Devsign-Project-rmtec/oLoRa/End Device/PCB/part/v19.1/BOM_oLoRa-part-Coprocessor_20190820155455.csv

ID | Name | Designator | Footprint | Quantity | Manufacturer Part | Manufacturer | Supplier | Supplier Part
1 | KMR221GLFS | SW3 | KEY-SMD-4.6X2.8X1.9 | 1 | KMR221GLFS | C&K | LCSC | C72443
2 | AVRISP-6 | ICSP2 | AVRISP | 1 | ?
3 | 100nF | C2 | 0603' | 1 | 0603B104K500NT | FH | LCSC | C30926
4 | ATMEGA328P-MU | U1 | QFN-32_5X5X05P | 1 | ATMEGA328P-MU | MICROCHIP | LCSC | C38896
5 | 8MHz | Y2 | X3-SMD-3.6X1.3X0.8MM | 1 | CSTCE8M00G55-R0
6 | 210S-1*10P | H1 | 210S-1X10P | 1 | 210S-1*10P L=11.6MMGold-plated black | Ckmtw | LCSC | C124372
