Devsign-Project-rmtec/oLoRa/End Device/PCB/part/v19.1/BOM_oLoRa-part-GPS_20190820155449.csv

ID | Name | Designator | Footprint | Quantity | Manufacturer Part | Manufacturer | Supplier | Supplier Part
1 | 100nF | C2,C1 | 0603' | 2 | 0603B104K500NT | FH | LCSC | C30926
2 | L80-R | U1 | L80-R | 1 | L80-R | Quectel | LCSC | C188357
3 | 210S-1*5P | H1 | 210S-1X5P | 1 | 210S-1*5P L=11.6MMGold-plated black | Ckmtw | LCSC | C124379
