Devsign-Project-rmtec/oLoRa/End Device/PCB/part/v19.1/BOM_oLoRa-part-LoRa_20190820155516.csv

ID | Name | Designator | Footprint | Quantity | Manufacturer Part | Manufacturer | Supplier | Supplier Part | LCSC Assembly
1 | NC | C19,C18 | 0805' | 2
2 | 0 | R22,R14 | 0603' | 2 | 0603WAF0000T5E | UniOhm | LCSC | C21189 | Yes
3 | U.FL-R-SMT-1(80) | JP1 | U.FL-R-SMT-1(80) | 1 | U.FL-R-SMT-1(80) | HRS | LCSC | C88374
4 | RAK811 | U7 | RAK811 LORA MODULE | 1 | RAK811 |  | RAK WIRELESS | RAK811
5 | Header-Male-2.54_1x4 | H1 | 210S-1X4P | 1 | 210S-1*4P L=11.6MMGold-plated black | Ckmtw | LCSC | C124378
