Devsign-Project-rmtec/oLoRa/End Device/PCB/part/v19.1/BOM_oLoRa-part-MainMCU_20190820155500.csv

ID | Name | Designator | Footprint | Quantity | Manufacturer Part | Manufacturer | Supplier | Supplier Part | LCSC Assembly
1 | AVRISP-6 | ICSP1 | AVRISP | 1 | ?
2 | 22 | R20,R19 | 0603' | 2
3 | 330 | R18,R17 | 0603' | 2
4 | KMR221GLFS | SW1 | KEY-SMD-4.6X2.8X1.9 | 1 | KMR221GLFS | C&K | LCSC | C72443
5 | PTC-2.0A | F2 | 1812 | 1 | MF-MSMF200-2 | BOURNS | LCSC | C210837
6 | micro 5P | USB1 | MICRO-USB-17 | 1 | - | LCSC | LCSC | C77238
7 | 8MHz | Y1 | X3-SMD-3.6X1.3X0.8MM | 1 | CSTCE8M00G55-R0
8 | 100nF | C17 | 0603' | 1 | CC0603KRX7R9BB104 | YAGEO | LCSC | C14663 | Yes
9 | ATMEGA32U4-MU | U6 | VQFN-44_L7.00-W7.00-PITCH0.50-EP5.2 | 1 | ATMEGA32U4-MU | MICROCHIP | LCSC | C112161
10 | ORH-R36A(0.6T) | LED1,LED2 | LED-0603 | 2 | ORH-R36A(0.6T) | Orient | LCSC | C205445
11 | 97.6K | R2 | 0603' | 1 | CR0603-FX-9762ELF | BOURNS | LCSC | C203901
12 | 309K | R3 | 0603' | 1 | 0603WAF3093T5E | UniOhm | LCSC | C23001 | Yes
13 | Z-211-0811-0021-001 | U1 | SIP-2.54MM-8P-CJT-H8.54 | 1 | Z-211-0811-0021-001 | Nextronics Engineering | LCSC | C190820
