Devsign-Project-rmtec/oLoRa/End Device/PCB/part/v19.1/BOM_oLoRa-part-motherboard_20190820155442.csv

ID | Name | Designator | Footprint | Quantity | Manufacturer Part | Manufacturer | Supplier | Supplier Part
1 | Z-211-0811-0021-001 | U2 | SIP-2.54MM-8P-CJT-H8.54 | 1 | Z-211-0811-0021-001 | Nextronics Engineering | LCSC | C190820
2 | 210S-1*10P | H6 | 210S-1X10P | 1 | 210S-1*10P L=11.6MMGold-plated black | Ckmtw | LCSC | C124372
3 | 5001 | U3 | CE-D-Z1.39-2.54 | 1 | 5001 | Keystone | LCSC | C238122
4 | A2541HWV-4P | H1,H2,H4 | A2541HWV-4P | 3 | A2541HWV-4P | Changjiang Connectors | LCSC | C225501
5 | Header-Female-2.54_1x5 | H3 | HDR-5X1/2.54 | 1 | 2.54mm 1*5p Female header | BOOMELE | LCSC | C50950
6 | Header-Female-2.54_1x6 | P1 | HDR-6X1/2.54 | 1 | Female header 1*6p | BOOMELE | LCSC | C40877
7 | Header-Female-2.54_1x8 | P2 | HDR-8X1/2.54 | 1 | Female headerHDR1X8-2.54 | BOOMELE | LCSC | C27438
8 | Header-Female-2.54_1x10 | H5 | HDR-TH_10PIN-V-FEMALE-PITCH2.54 | 1 | 2.54mm 1*10P Straight Female header Gold-plated | BOOMELE | LCSC | C35445
