Devsign-Project-rmtec/oLoRa/End Device/PCB/part/v19.1/BOM_oLoRa-part-power_20190820155506.csv

ID | Name | Designator | Footprint | Quantity | Manufacturer Part | Manufacturer | Supplier | Supplier Part | LCSC Assembly
1 | 1.2k | R16 | 0603' | 1
2 | 1k | R15,R2 | 0603' | 2
3 | K3-1296S-E1 | SW2 | K3-1296S-E1 | 1 | K3-1296S-E1 | HRO | LCSC | C128955
4 | SGM2036-3.3YN5G/TR | U5 | SOT-23-5 | 1 | SGM2036-3.3YN5G/TR | SGMICRO | LCSC | C92402 | Yes
5 | TP4056 | U4 | SOP-8_EP_150MIL | 1 | TP4056 | TOPPOWER | LCSC | C16581 | Yes
6 | 10uF | C16,C15 | CAP-CASE-A_3216 | 2 | TAJA106K016RNJ | AVX | LCSC | C7171 | Yes
7 | RED | LED4 | LED-0603 | 1 | KT-0603R | KENTO | LCSC | C2286 | Yes
8 | GRN | LED3 | LED-0603 | 1 | 19-217/GHC-YR1S2/3T | EVERLIGHT | LCSC | C72043 | Yes
9 | 10nF | C14 | 0603' | 1 | CGA3E2C0G1H103JT0Y0N | TDK | LCSC | C76710 | Yes
10 | 1uF | C8,C7 | 0603' | 2 | CL10B105KQ8NNNC | SAMSUNG | LCSC | C105524
11 | Header-Male-2.54_1x4 | H1 | 210S-1X4P | 1 | 210S-1*4P L=11.6MMGold-plated black | Ckmtw | LCSC | C124378
12 | MTP220 | H2 | PH-TH_2PIN-H-MALE-PITCH2.00-L | 1 | MTP220-1102R1 | MINTRON | LCSC | C376096
