Devsign-Project-rmtec/oLoRa/End Device/PCB/part/v19.1/BOM_oLoRa-part-thi_20190820155435.csv

ID | Name | Designator | Footprint | Quantity | Manufacturer Part | Manufacturer | Supplier | Supplier Part | LCSC Assembly
1 | SHT20 | U1 | DFN-6-EP | 1 | SHT20 | Sensirion | LCSC | C53865 | Yes
2 | MPU-6050_C24112 | U2 | QFN-24_4X4X05P | 1 | MPU-6050 | InvenSense | LCSC | C24112 | Yes
3 | Header-Male-2.54_1x4 | H1 | 210S-1X4P | 1 | 210S-1*4P L=11.6MMGold-plated black | Ckmtw | LCSC | C124378
4 | 100nF | C4,C1 | 0603' | 2 | 0603B104K500NT | FH | LCSC | C30926
5 | 10nF | C2 | 0603' | 1 | CC0603KRX7R9BB103 | YAGEO | LCSC | C100042
6 | 2.2nF | C3 | 0603' | 1 | CC0603KRX7R9BB222 | YAGEO | LCSC | C107082
