Devsign-Project-rmtec/oLoRa/End Device/PCB/part/v19.1/BOM_oLoRa-part-Geiger_20190820155511.csv

ID | Name | Designator | Footprint | Quantity | Manufacturer Part | Manufacturer | Supplier | Supplier Part | LCSC Assembly
1 | 10 | R21 | 0805' | 1 | RC0805FR-0710RL | YAGEO | LCSC | C96347
2 | 1K | R12,R3,R11,R10 | 0603' | 4 | RC0603FR-071KL | YAGEO | LCSC | C22548
3 | 100uF | C13 | CASE-B_3528 | 1 | TAJB107M010RNJ | AVX | LCSC | C7196 | Yes
4 | 10K | R13 | 0603' | 1 | 0603WAF1002T5E | UniOhm | LCSC | C25804 | Yes
5 | 100K | R9,R1 | 0603' | 2 | RC0603FR-07100KL | YAGEO | LCSC | C14675
6 | 10M | R8,R7,R6,R5,R4 | 0603' | 5 | RTT031005FTP | RALEC | LCSC | C103202
7 | 100pF | C12,C11 | 0603' | 2 | 0603CG101J500NT | FH | LCSC | C1635 | Yes
8 | 10nF 1kV | C10,C9,C6,C5 | 1206 | 4 | 1206B103K102CT | Huaxin S&T | LCSC | C303948
9 | 100nF | C4 | 0603' | 1 | 0603B104K500NT | FH | LCSC | C30926
10 | 10mH | L1 | IND-505040 | 1 | FNR5040S103MT | cjiang | LCSC | C167995
11 | MMBT3904 | Q1 | SOT-23(SOT-23-3) | 1 | MMBT3904 | SK | LCSC | C111113 | Yes
12 | MMBTA44G | Q3 | SOT-23(SOT-23-3) | 1 | MMBTA44G-AE3-R | UTC | LCSC | C84882 | Yes
13 | ES1J | D3,D2,D1 | SMA(DO-214AC) | 3 | ES1J | ON Semicon | LCSC | C232830
14 | WJ142V-5.08-02P-14-00A | CN1 | WJ142V-5.08-2P | 1 | WJ142V-5.08-02P-14-00A | Ningbo Kangnex Elec | LCSC | C153288
15 | Header-Male-2.54_1x6 | P1 | HDR-6X1/2.54 | 1 | Header-Male-2.54_1x6 | BOOMELE | LCSC | C37208
