Devsign-Project-rmtec/oLoRa/End Device/PCB/part/v19.1/Schematic_oLoRa-part-LoRa_part-LoRa_20190820155410.pdf

## https://pdf.direnc.net/upload/rak811-breakout-board-specification.pdf

## LoRa Module

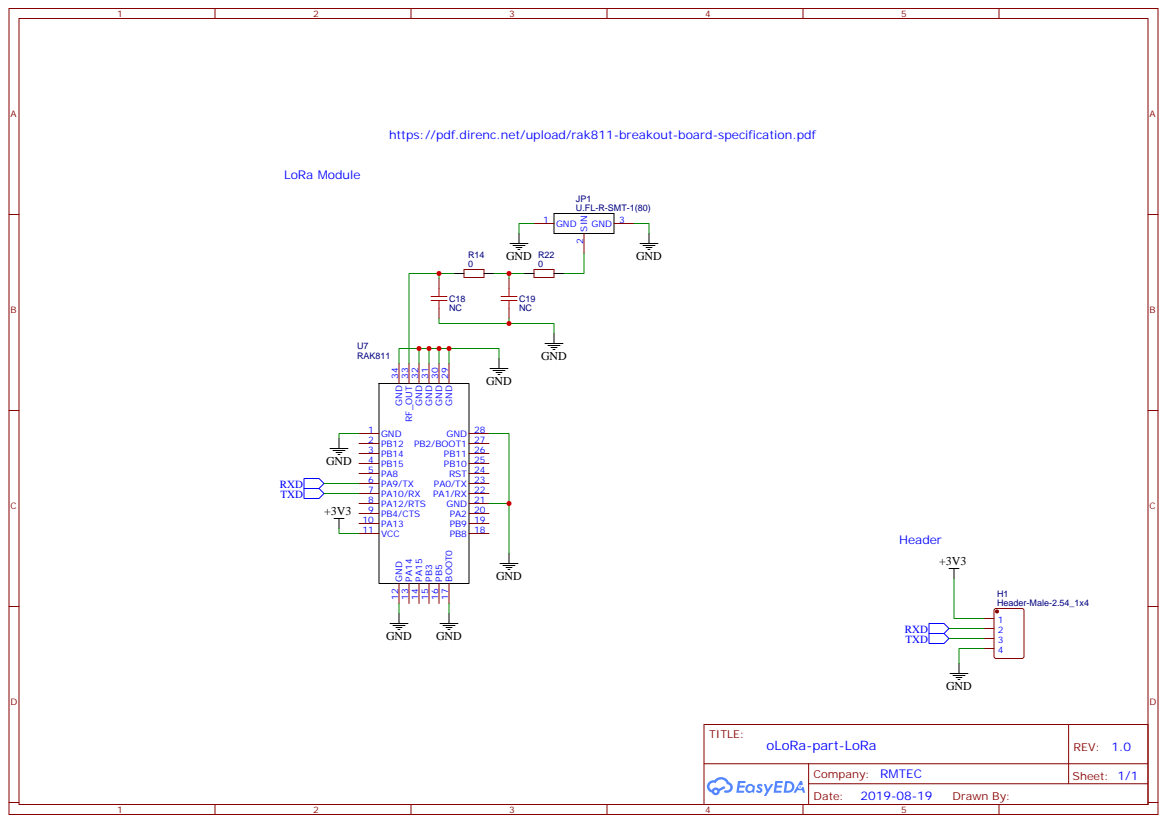
[picture p1: page 1]

RAK811
PB8 18 PB9 19 PA2 20 GND 21 PA1/RX 22 PA0/TX 23 RST 24 PB10 25 PB11 26 PB2/BOOT1 27 GND 28 GND ²⁹ GND ³⁰ GND ³¹ GND ³² RF_OUT 33 GND ³⁴
