Devsign-Project-rmtec/oLoRa/End Device/PCB/part/v19.1/Schematic_oLoRa-part-thi_part-thi_20190820155421.pdf

## https://components101.com/sensors/mpu6050-module

## Accel Gyro Sensor

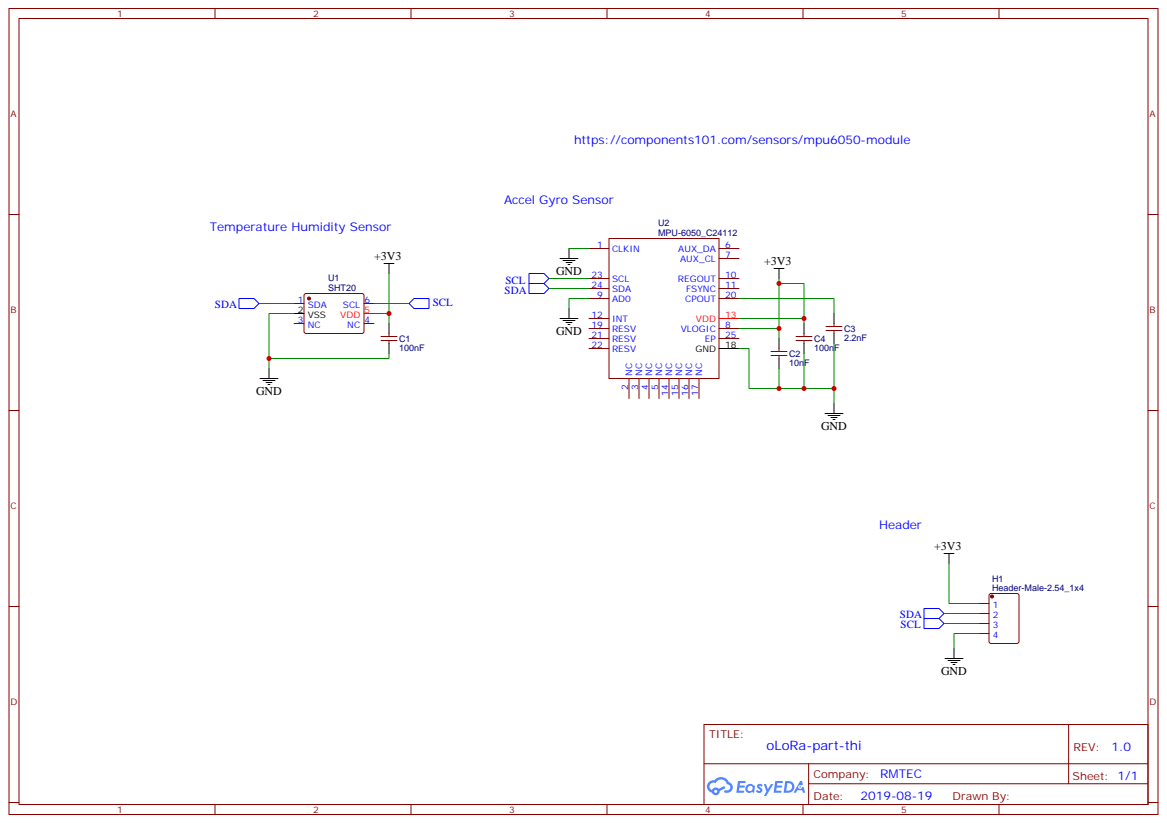
[picture p2: page 1]
