Devsign-Project-rmtec/oLoRa/End Device/PCB/part/v19.1/Schematic_oLoRa-part-Coprocessor_part-coprocessor_20190820155325.pdf

## ICSP Header

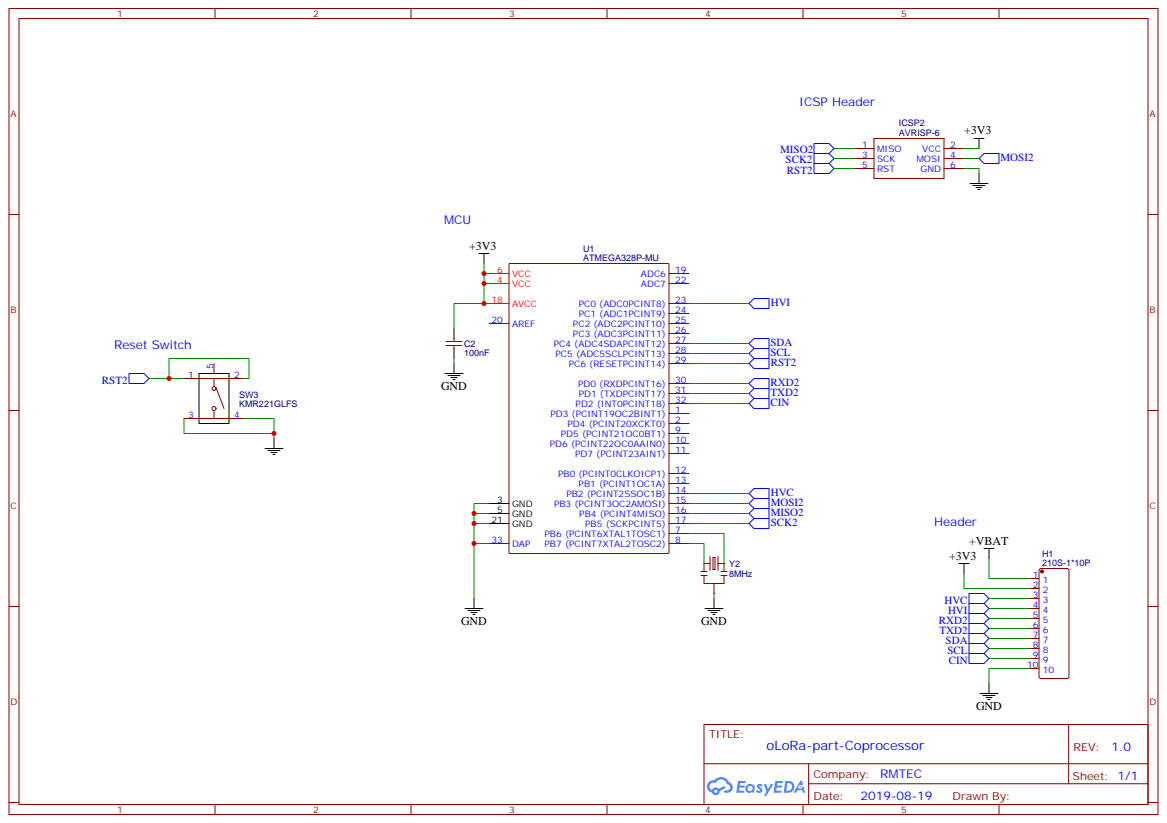
[picture p3: page 1]
