Devsign-Project-rmtec/oLoRa/End Device/PCB/part/v19.1/Schematic_oLoRa-part-Geiger_part-geiger_20190820155359.pdf

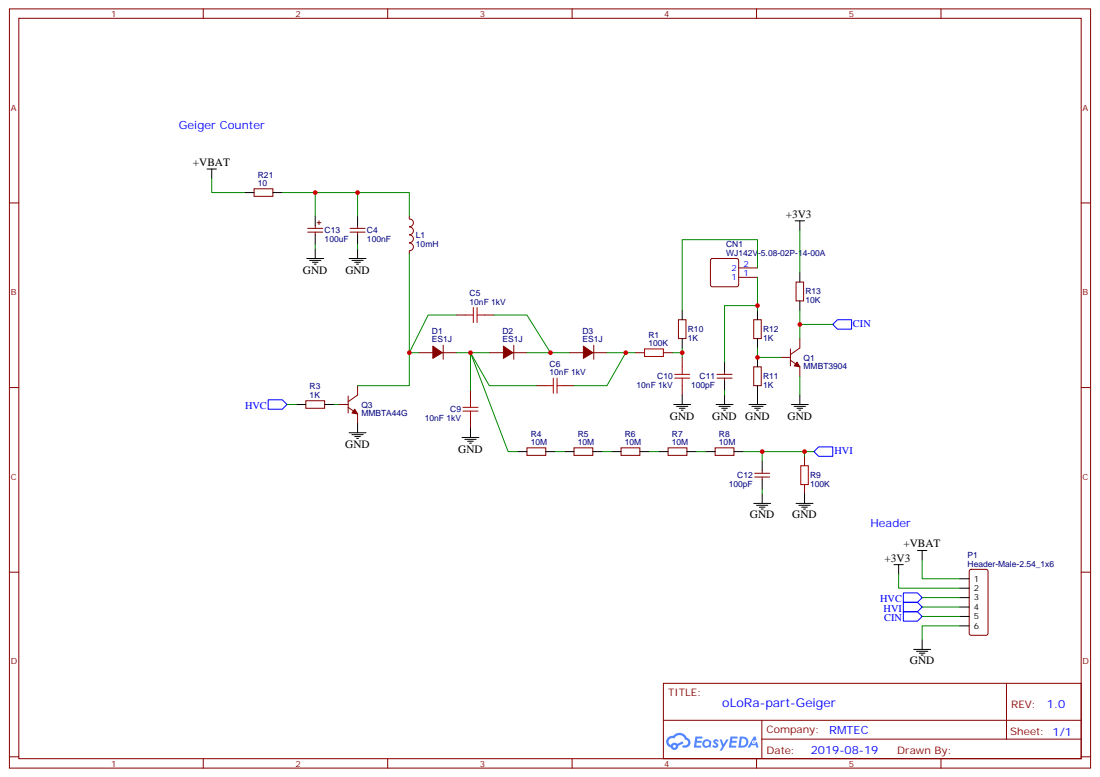
[picture p4: page 1]
