Devsign-Project-rmtec/oLoRa/End Device/PCB/part/v19.1/Schematic_oLoRa-part-GPS_part-GPS_20190820155313.pdf

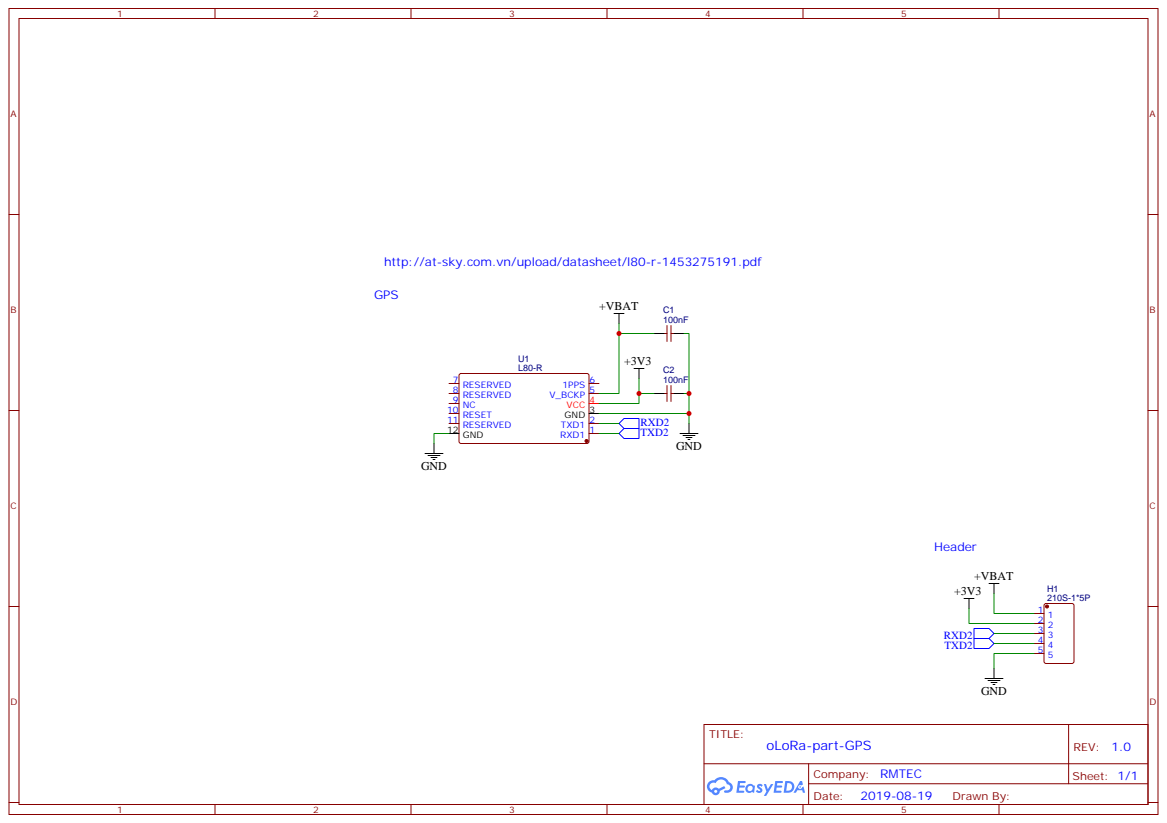
[picture p5: page 1]

http://at-sky.com.vn/upload/datasheet/l80-r-1453275191.pdf
