Devsign-Project-rmtec/oLoRa/End Device/PCB/part/v19.1/Schematic_oLoRa-part-MainMCU_part-MainMCU_20190820155343.pdf

## ICSP Header

## USB Part

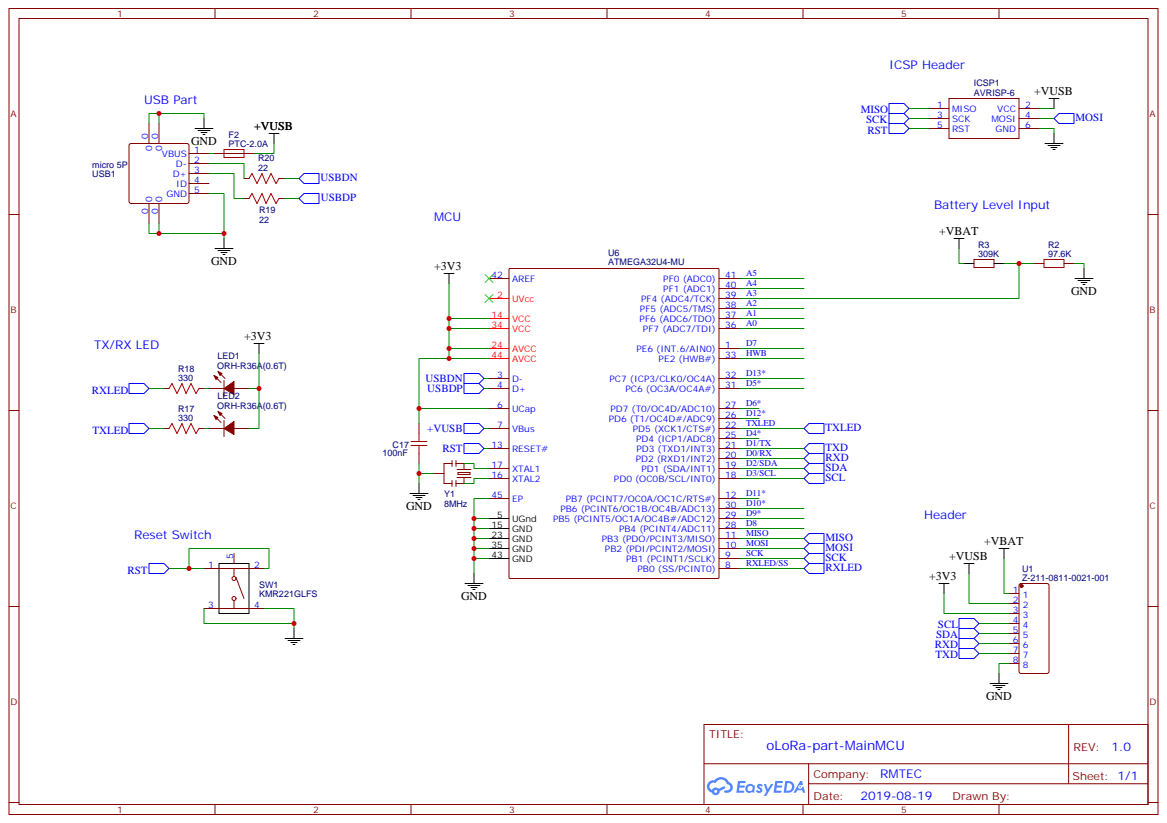
[picture p6: page 1]
