Devsign-Project-rmtec/oLoRa/End Device/PCB/part/v19.1/Schematic_oLoRa-part-motherboard_part-motherboard_20190820155153.pdf

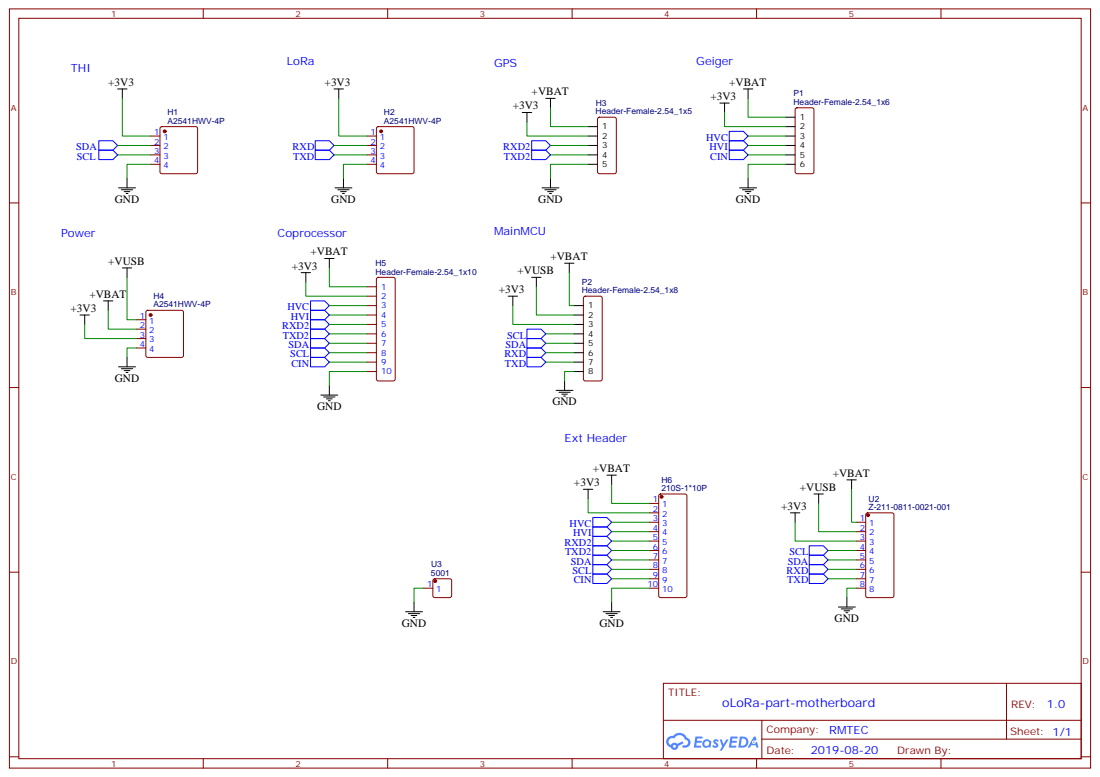
[picture p7: page 1]
