Devsign-Project-rmtec/oLoRa/(commit log)

2019-08-06 battery header init
2019-08-20 part v19.1 Sch & PCB added
    [BOM_oLoRa-part-Coprocessor_20190820155455.csv, BOM_oLoRa-part-GPS_20190820155449.csv, BOM_oLoRa-part-Geiger_20190820155511.csv, BOM_oLoRa-part-LoRa_20190820155516.csv, BOM_oLoRa-part-MainMCU_20190820155500.csv, BOM_oLoRa-part-motherboard_20190820155442.csv, BOM_oLoRa-part-power_20190820155506.csv, BOM_oLoRa-part-thi_20190820155435.csv]
2019-09-16 test board code & packet format redefined
2019-09-17 GPS and temperature bug fixed
    [gps_processor.h, packet.h]
2019-09-26 HV Control, GPS parser, I2C init added
2019-10-10 i2c bugfix, temporary switched to arduino mega
    [GPSProcessor.h, GeigerProcessor.h, gps-geiger.ino]
